HexabitzPlatform/H05R0x/README.md

# H05R0x-Hardware
Hexabitz 1S Lipo Charger w/ USB-C Module Hardware Design
