HexabitzPlatform/H05R0x/Rleased/BOM/H05R0.xlsx

 |  | www.hexabitz.com info@hexabitz.com |  | Bill Of Materials
Customer | Hexabitz | Revision | 1
Project | Hexabitz Modules | Date | 2024-10-07
Board | 1s Lipo charger w/ USB-C (H05R0) | Notes
Designator | Description | Manufacturer Part Number | Manufacturer | Octopart Url | Quantity
R | Headers & Wire Housings Unshrouded 1 POS T/H | 5-146280-1 | TE Connectivity | https://octopart.com/5-146280-1-te+connectivity+%2F+amp-40259676?r=sp | 1
EXT_TH_J, PIO_J | 2 Position Total Single Row 2.54 mm Pitch Straight Male Thru-Hole Header | M20-9990245 | HARWIN INC | https://octopart.com/m20-9990245-harwin-7492269?r=sp | 2
SWD | Conn Unshrouded Header HDR 3 POS 2.54mm Solder ST Top Entry Thru-Hole Carton | 5-146281-3 | TE Connectivity | https://octopart.com/5-146281-3-te+connectivity+%2F+amp-39745942?r=sp | 1
BAT_J | Wire-To-Board Connector, Top Entry, 2 mm, 2 Contacts, Header, PH Series, Through Hole, 1 Rows | b2b-ph-k-s(lf)(sn) | JST | https://octopart.com/b2b-ph-k-s%28lf%29%28sn%29-jst-248868?r=sp | 1
BAT_J2 | VH Series 2 Position 3.96 mm Pitch Disconnectable Crimp Style Shrouded Header | B2P-VH-FB-B(LF)(SN) | JST | https://octopart.com/b2p-vh-fb-b%28lf%29%28sn%29-jst-3990178?r=sp | 1
USB_C | CONN RCP USB3.1 TYPEC 24P SMD RA | 12401610E4#2A | Amphenol ICC | https://octopart.com/12401610e4%232a-amphenol+communications+solutions-126516878?r=sp | 1
VBUS_OUT_J | 2pin Terminal Block; Printed Circuit; 10 A; 160 V; 3.5 mm; 2; 3.5 mm; 1.2 mm; M2; PA | 1984617 | Phoenix Contact | https://octopart.com/1984617-phoenix+contact-58834?r=sp&s=Ef_UaV1JSFmY0wggQyN1Mw | 1
R5 | RES 0.003 OHM 1.0 W 1% 1206 SMD | WFC12063L000FE66 | Vishay | https://octopart.com/wfc12063l000fe66-vishay+dale-125245933?r=sp | 1
R1 | Current Sense Resistors - SMD 1/2W 10m ohm 1% | KRL1220E-M-R010-F-T5 | Susumu | https://octopart.com/krl1220e-m-r010-f-t5-susumu-24927387?r=sp | 1
R12 | RES 10 OHM 1% 1/10W 0603 | CRCW060310R0FKEB | Vishay | https://octopart.com/crcw060310r0fkeb-vishay-42507905?r=sp | 1
R9, R15, R16, R17, R29 | RES 100 OHM 1% 1/10W 0603 | AC0603FR-13100RL | Yageo | https://octopart.com/ac0603fr-13100rl-yageo-74169481?r=sp | 5
R2,R24 | Thick Film Resistors - SMD 0603 270 Ohm 5% Tol | ERJ-3GEYJ271V | Panasonic | https://octopart.com/erj-3geyj271v-panasonic-55560546?r=sp | 2
R4, R6, R7, R10, R18 | RES 1K OHM 1% 1/10W 0603 | AC0603FR-131KL | Yageo | https://octopart.com/ac0603fr-131kl-yageo-73876229?r=sp | 5
R33 | RES THICK FILM 2K OHM 1/10W 1% 0603 SMD | RC0603FR-072KL | YAGEO | https://octopart.com/rc0603fr-072kl-yageo-39838380?r=sp | 1
R3, R11, R21, R37, R39 | RES 10K Ohm 1% 0603 | RC0603FR-0710KL | Yageo | https://octopart.com/rc0603fr-0710kl-yageo-40025538?r=sp | 5
R13, R14 | NTC Thermistors 10K OHM 1% | NCP18XH103F03RB | Murata Electronics | https://octopart.com/ncp18xh103f03rb-murata-746135?r=sp | 2
R27, R31 | RES THICK FILM 20.0K OHM 1/10W 1% 0603 SMD | RC0603FR-0720KL | Yageo | https://octopart.com/rc0603fr-0720kl-yageo-1197359?r=sp | 2
R35, R36 | 0603 22K Ohm 1% 0.1W | RMCF0603FG22K0 | Stackpole Electronics | https://octopart.com/rmcf0603fg22k0-stackpole+electronics-19773159?r=sp | 2
R32 | RES SMD 27K OHM 1% 1/10W 0603 | AC0603FR-0727KL | Yageo | https://octopart.com/ac0603fr-0727kl-yageo-28165829?r=sp | 1
R26 | RES 47K OHM 1% 1/10W 0603 | RC0603FR-0747KL | Yageo | https://octopart.com/rc0603fr-0747kl-yageo-1369017?r=sp | 1
R8, R20 | RES 49.9K OHM 1% 1/10W 0603 | RC0603FR-0749K9L | Yageo | https://octopart.com/rc0603fr-0749k9l-yageo-1186134?r=sp | 2
R22, R34 | RES 100K OHM 1% 1/10W 0603 | RC0603FR-07100KL | Yageo | https://octopart.com/rc0603fr-07100kl-yageo-40946036?r=sp | 2
R25, R28 | RES SMD 220K OHM 5% 1/10W 0603 | 0603WAJ0224T5E | ROYAL OHM | https://octopart.com/0603waj0224t5e-royal+ohm-127836159?r=sp | 2
R38 | RES 1M OHM 1% 1/10W 0603 | RC0603FR-071ML | Yageo | https://octopart.com/rc0603fr-071ml-yageo-1168402?r=sp | 1
R19 | RES 2M OHM 1% 1/10W 0603 | RC0603FR-102ML | Yageo | https://octopart.com/rc0603fr-102ml-yageo-16255871?r=sp | 1
C9, C14 | CAP CER 1000PF 50V C0G/NPO 0603 | CC0603KRNPO9BN102 | YAGEO | https://octopart.com/cc0603krnpo9bn102-yageo-65850404?r=sp | 2
C18 | CAP CER 0.022UF 50V X7R 0603 | C1608X7R1H223K080AA | TDK CORPORAT ION [VA] | https://octopart.com/c1608x7r1h223k080aa-tdk-25947667?r=sp | 1
C10, C16 | Cap Ceramic 0.033uF 16V X7R 10% SMD 1.6 x 0.8 mm 125 C Paper T/R | C0603C333K4RACTU | KEMET [VA] | https://octopart.com/c0603c333k4ractu-kemet-9143755?r=sp | 2
C1, C2, C4, C12, C13, C21, C22, C23, C24, C25, C26, C27, C31 | CAP CER 0.1 UF 25V 10% X7R 0603 | CL10B104KA8NNNC | Samsung Electro-Mechanics | https://octopart.com/cl10b104ka8nnnc-samsung-19831573?r=sp | 13
C17 | 0603 0.47 uF 10 V ±10% Tolerance X7R Surface Mount Multilayer Ceramic Capacitor | GRM188R71A474KA61D | Murata | https://octopart.com/grm188r71a474ka61d-murata-11812018?r=sp | 1
C5, C6, C20, C28, C29, C30 | CAP CER 1 UF 16V X7R 0805 | CC0805KKX7R7BB105 | YAGEO [VA] | https://octopart.com/cc0805kkx7r7bb105-yageo-8376555?r=sp | 6
C3 , C7 | CAP CER 4.7UF 16V X7R 0805 | C0805C475K4RACTU | KEMET [VA] | https://octopart.com/c0805c475k4ractu-kemet-22859922?r=sp | 2
C19, C11, C15 | Cap Ceramic 10uF 25V X5R 10% Pad SMD 0805 | 08053D106KAT2A | AVX | https://octopart.com/08053d106kat2a-avx-71037153?r=sp | 3
C8, C32 | Cap Ceramic 22uF 35V JB 20% Pad SMD 0805 85C T/R | C2012JB1V226M125AC | TDK | https://octopart.com/c2012jb1v226m125ac-tdk-28168958?r=sp | 2
FB1 | Ind chip Bead Multi-Layer 30 ohms 25% 100MHZ Ferrite 1,5A 0603Punched paper T/R | MMZ1608Y300BTA00 | TDK | https://octopart.com/mmz1608y300bta00-tdk-7906990?r=sp | 1
D1 | Red 0603 130° Clear 54 mcd 2 V Surface Mount ChipLED | VLMS1300-GS08 | Vishay | https://octopart.com/vlms1300-gs08-vishay-21709201?r=sp | 1
D2 | V-Ref Adjustable 2.5V to 24V 100mA 3-Pin SOT-23 T/R / IC VREF SHUNT ADJ SOT23-3 | TS2431BILT | STMicroelectronics | https://octopart.com/ts2431bilt-stmicroelectronics-527041?r=sp | 1
D3 | LED Uni-Color True Green 530nm 2-Pin Chip 0603(1608Metric) T/R | VLMTG1300-GS08 | Vishay | https://octopart.com/vlmtg1300-gs08-vishay-21709202?r=sp | 1
D4 | TVS DIODE 3,3V 10,9V SOD323 | CDSOD323-T03SC | BOURNS INC | https://octopart.com/cdsod323-t03sc-bourns-10487153?r=sp | 1
D5, D6, D7 | Schottky Diode, 30V, 1A, Sod-323 | CUS10S30,H3F(T | Toshiba | https://octopart.com/cus10s30%2Ch3f%28t-toshiba-98975237?r=sp | 3
Q1 | Transistor MOSFET Array Dual N-CH 30V 28A 8-Pin PowerPAK 1212 | SISF06DN-T1-GE3 | Vishay | https://octopart.com/sisf06dn-t1-ge3-vishay-108916351?r=sp | 1
U1 | MCU 32-bit ARM Cortex M0+ RISC 512KB Flash 1.8V/2.5V/3.3V 48-Pin UFQFPN EP Tray | STM32G0B1CEU6 | STMicroelectronics | https://octopart.com/stm32g0b1ceu6-stmicroelectronics-116363364?r=sp | 1
U2 | Battery Management 1 Cell Fuel Gauge with ModelGauge m5 EZ, Charger, Protector and SHA-256 Authentication | MAX17330X22+T | Analog Devices / Maxim Integrated | https://octopart.com/max17330x22%2Bt-analog+devices-119633547?r=sp | 1
U3 | Op Amp Dual High Bandwidth Amplifier R-R I/O 5.5V 8-Pin DFN EP T/R | TSV772IQ2T | STMicroelectronics | https://octopart.com/tsv772iq2t-stmicroelectronics-123138659?r=sp | 1
U4 | LDO Voltage Regulators 2 A high PSRR ultra low drop linear regulator reverse current protection | LD39200PU33R | STMicroelectronics | https://octopart.com/ld39200pu33r-stmicroelectronics-49646134?r=sp | 1
U5 | 0.5V~13.5V 12.8mΩ 10.5A DFN-8(2x2) Power Distribution Switches ROHS | NCP45521IMNTWG-L | onsemi | https://octopart.com/ncp45521imntwg-l-onsemi-24638146?r=sp | 1
U6 | 300 mA 3.3 V Fixed Low Noise LDO Voltage Regulator - SOT-323-5 | LDK130C33R | STMicroelectronics | https://octopart.com/ldk130c33r-stmicroelectronics-29288945?r=sp | 1
X1 | 8,0000MHZ 33pF SMD MURATA Resonators | CSTNE8M00G550000R0 | Murata | https://octopart.com/cstne8m00g550000r0-murata-91406934?r=sp | 1
