HexabitzPlatform/H05R0x/Documentation/H05R0 Schematics.pdf

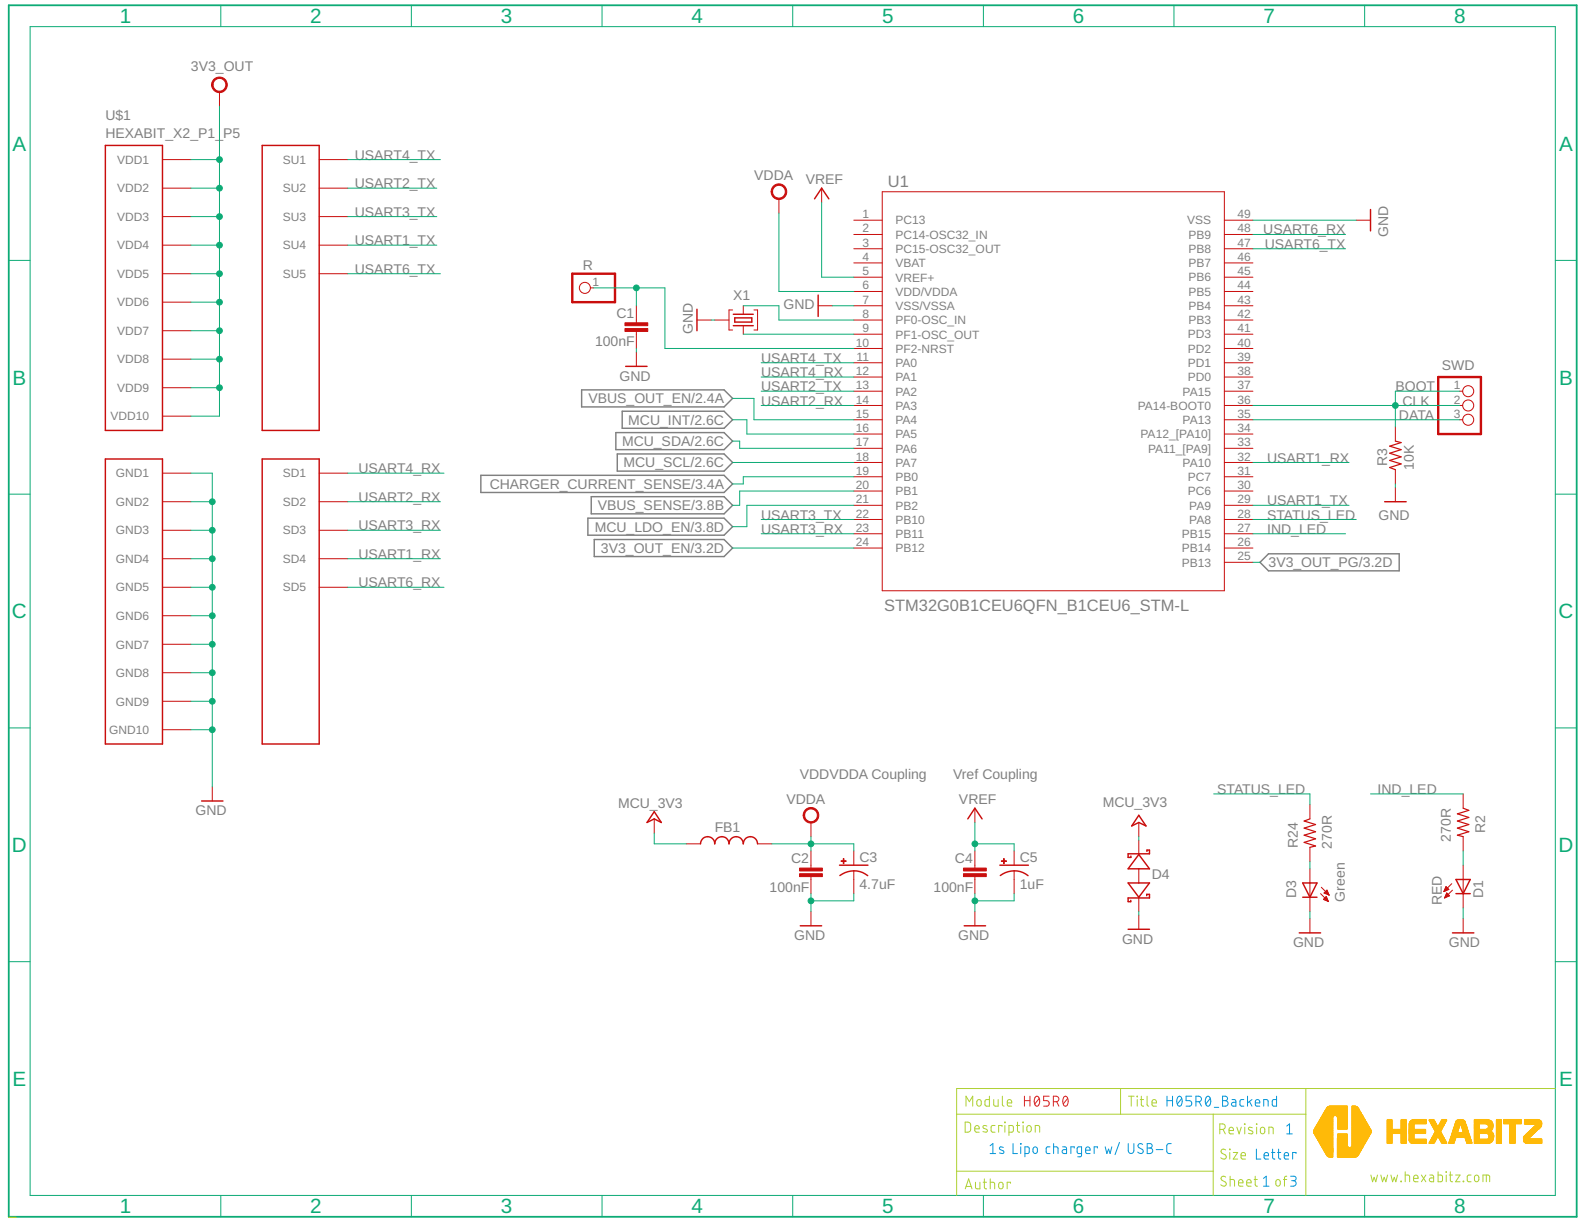
[picture p1: page 1]

35 PA14-BOOT0 | DATA
32 PA11_[PA9] 33 PA12_[PA10] 34 PA13 USART1_RX STATUS_LED GND IND_LED

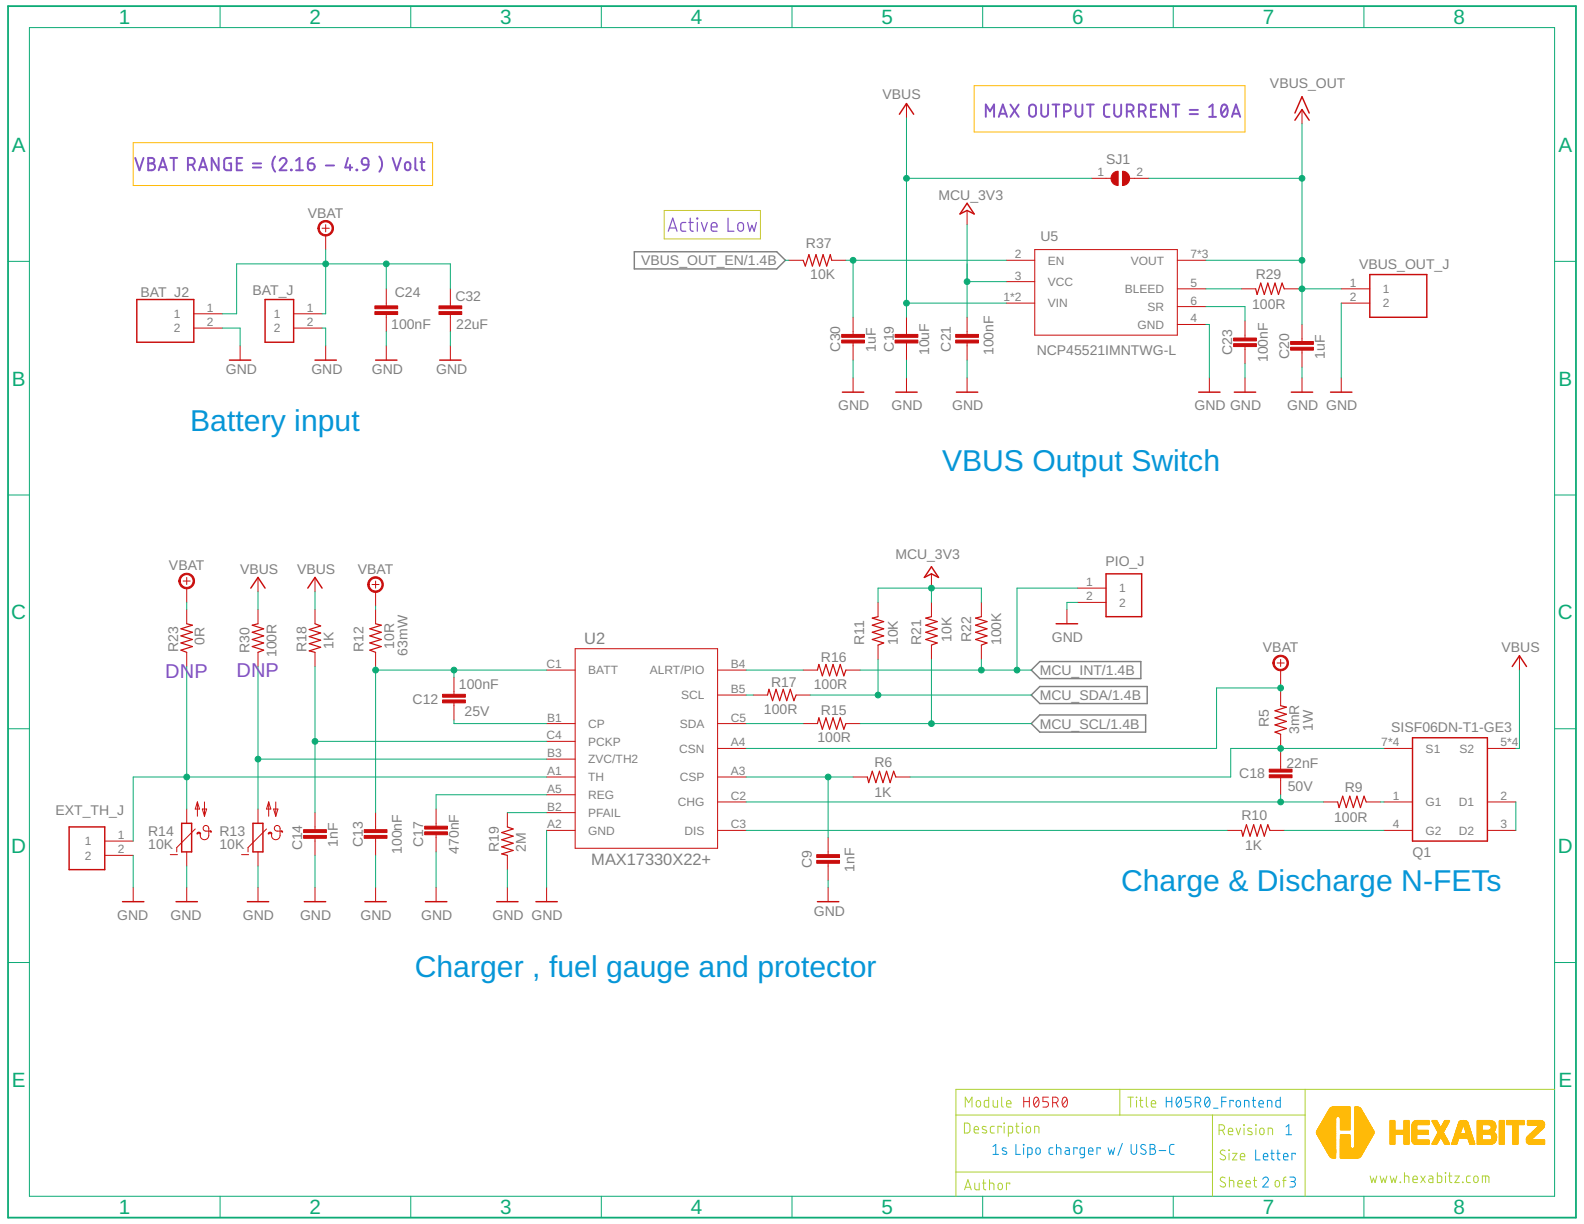
[picture p2: page 2]

Charger , fuel gauge and protector

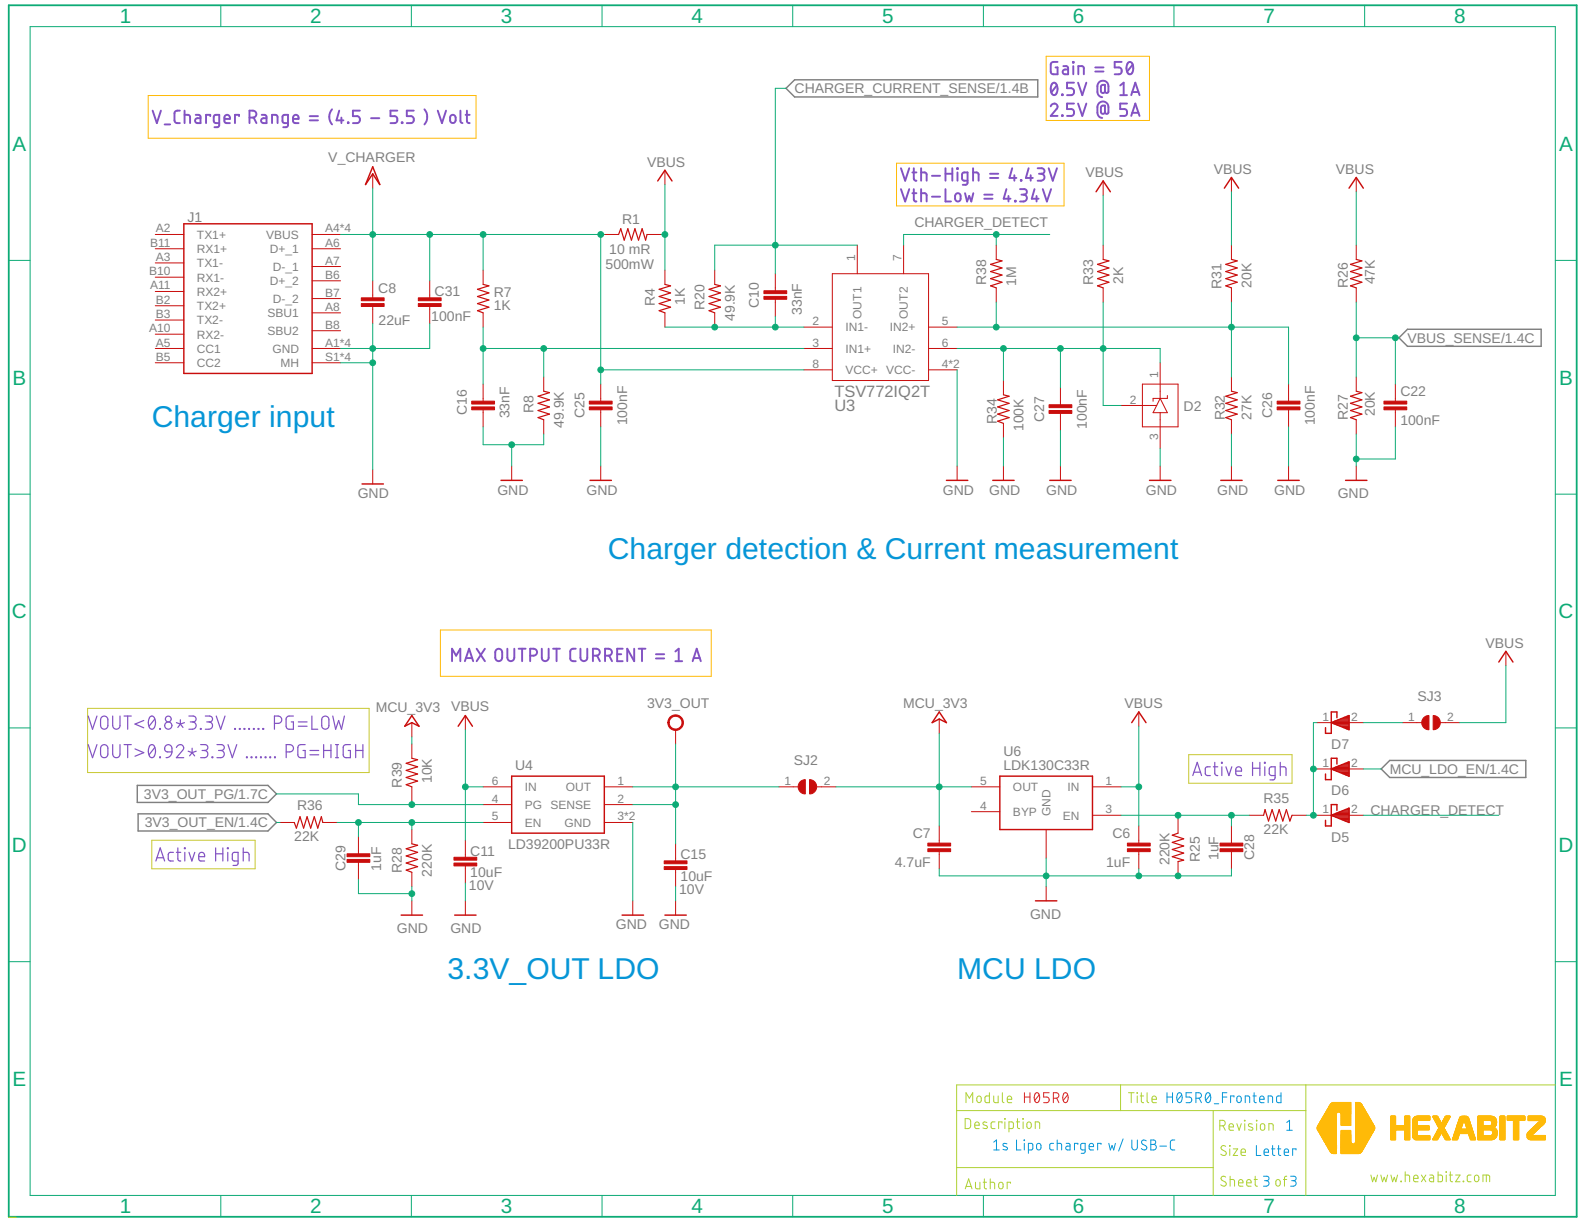
[picture p3: page 3]

Charger detection & Current measurement
