HexabitzPlatform/H05R0x/Design/H05R0.brd

## EAGLE design Design/H05R0.brd (2024-10-08)

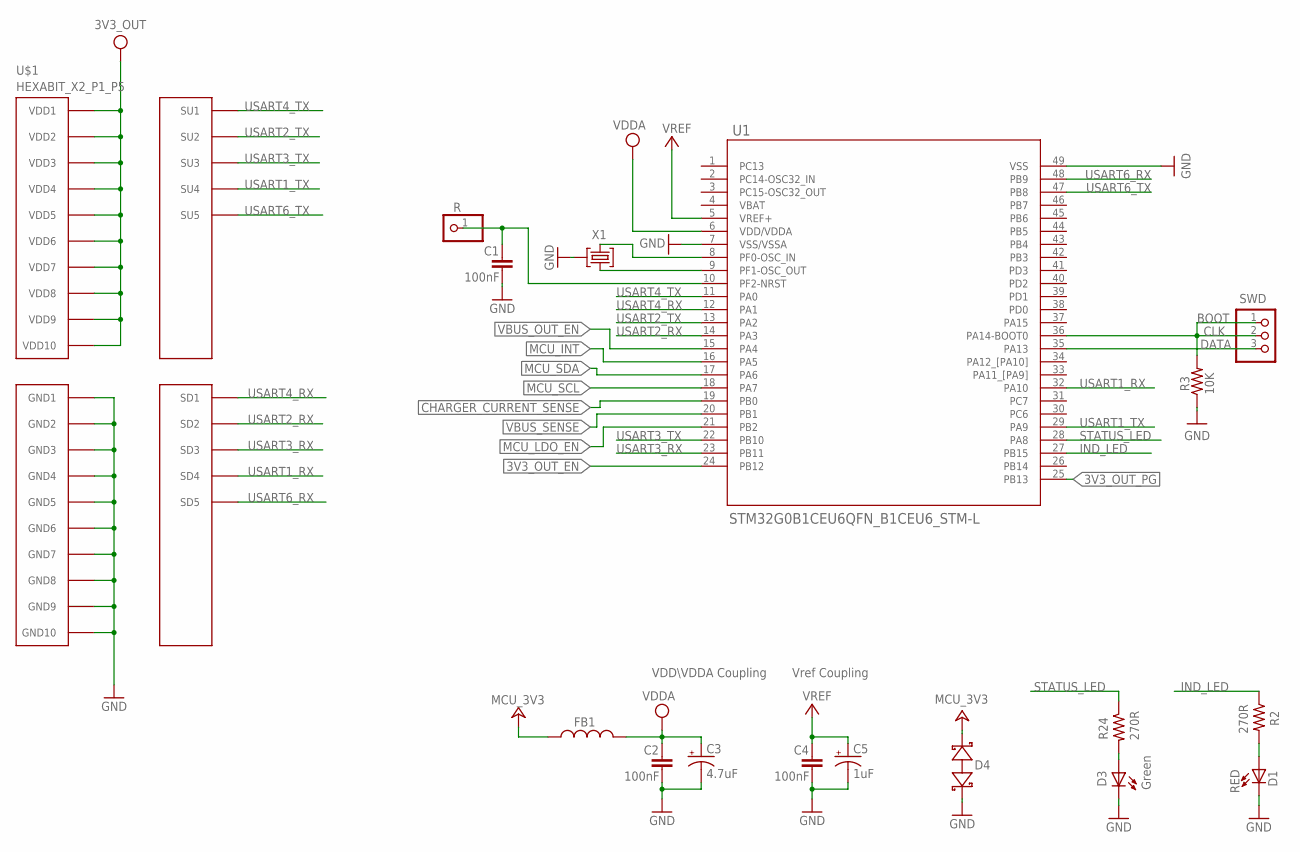
[picture p4: schematic H05R0.sch, sheet 1]

Parts:
C1, C2, C4: 100nF; C-0603
C3: 4.7uF; C-0805-POL
C5: 1uF; C-0805-POL
D1: RED; VLMS1300-GS08; MPN VLMS1300-GS08
D3: Green; VLMTG1300-GS08; MPN VLMS1300-GS08
D4: BOURNS_CDSOD323-T03SCBOURNS_CDSOD323-T03SC_0_0; BOURNS_CDSOD323-T03SC_0
FB1: FB-0603
R: R; 1X01
R2, R24: 270R; R-0603
R3: 10K; R-0603
SWD: PINHD-1X3; 1X03
TRIMBLE-LOGO1: HEXA-LOGO
U1: STM32G0B1CEU6QFN_B1CEU6_STM-L; QFN_B1CEU6_STM-L
U$1: HEXABIT_X2_P1_P5; HEXABIT_17.32_X2_P1_P5
X1: XTALL_CSTCE8M00G52

Connections:
3V3_OUT: U$1.PAD_PU11 (VDD1), U$1.PAD_PU12 (VDD2), U$1.PAD_PU13 (VDD3), U$1.PAD_PU14 (VDD4), U$1.PAD_PU15 (VDD5), U$1.PAD_PU16 (VDD6), U$1.PAD_PU17 (VDD7), U$1.PAD_PU18 (VDD8), U$1.PAD_PU19 (VDD9), U$1.PAD_PU20 (VDD10); also elsewhere on the board
3V3_OUT_EN: U1.24 (PB12); also elsewhere on the board
3V3_OUT_PG: U1.25 (PB13); also elsewhere on the board
CHARGER_CURRENT_SENSE: U1.19 (PB0); also elsewhere on the board
CLK: R3.2, SWD.1, SWD.2, U1.36 (PA14-BOOT0)
DATA: SWD.3, U1.35 (PA13)
GND: C1.2, C2.2, C3.2 (-), C4.2, C5.2 (-), D1.C, D3.C, D4.1 (A), R3.1, U1.7 (VSS/VSSA), U1.49 (VSS), U$1.PAD_PD11 (GND1), U$1.PAD_PD12 (GND2), U$1.PAD_PD13 (GND3), U$1.PAD_PD14 (GND4), U$1.PAD_PD15 (GND5), U$1.PAD_PD16 (GND6), U$1.PAD_PD17 (GND7), U$1.PAD_PD18 (GND8), U$1.PAD_PD19 (GND9), U$1.PAD_PD20 (GND10), X1.P$2 (2); also elsewhere on the board
IND_LED: R2.1, U1.27 (PB15)
MCU_3V3: D4.2 (C), FB1.2; also elsewhere on the board
MCU_INT: U1.16 (PA5); also elsewhere on the board
MCU_LDO_EN: U1.21 (PB2); also elsewhere on the board
MCU_SCL: U1.18 (PA7); also elsewhere on the board
MCU_SDA: U1.17 (PA6); also elsewhere on the board
unnamed: D1.A, R2.2
unnamed: D3.A, R24.2
unnamed: U1.9 (PF1-OSC_OUT), X1.P$1 (1)
unnamed: U1.8 (PF0-OSC_IN), X1.P$3 (3)
unnamed: C1.1, R.1, U1.10 (PF2-NRST)
STATUS_LED: R24.1, U1.28 (PA8)
USART1_RX: U1.32 (PA10), U$1.PAD_PD4 (SD4)
USART1_TX: U1.29 (PA9), U$1.PAD_PU4 (SU4)
USART2_RX: U1.14 (PA3), U$1.PAD_PD2 (SD2)
USART2_TX: U1.13 (PA2), U$1.PAD_PU2 (SU2)
USART3_RX: U1.23 (PB11), U$1.PAD_PD3 (SD3)
USART3_TX: U1.22 (PB10), U$1.PAD_PU3 (SU3)
USART4_RX: U1.12 (PA1), U$1.PAD_PD1 (SD1)
USART4_TX: U1.11 (PA0), U$1.PAD_PU1 (SU1)
USART6_RX: U1.48 (PB9), U$1.PAD_PD5 (SD5)
USART6_TX: U1.47 (PB8), U$1.PAD_PU5 (SU5)
VBUS_OUT_EN: U1.15 (PA4); also elsewhere on the board
VBUS_SENSE: U1.20 (PB1); also elsewhere on the board
VDDA: C2.1, C3.1 (+), FB1.1, U1.6 (VDD/VDDA)
VREF: C4.1, C5.1 (+), U1.5 (VREF+)

Notes on the sheet:
Vref Coupling
VDD\VDDA Coupling
BOOT

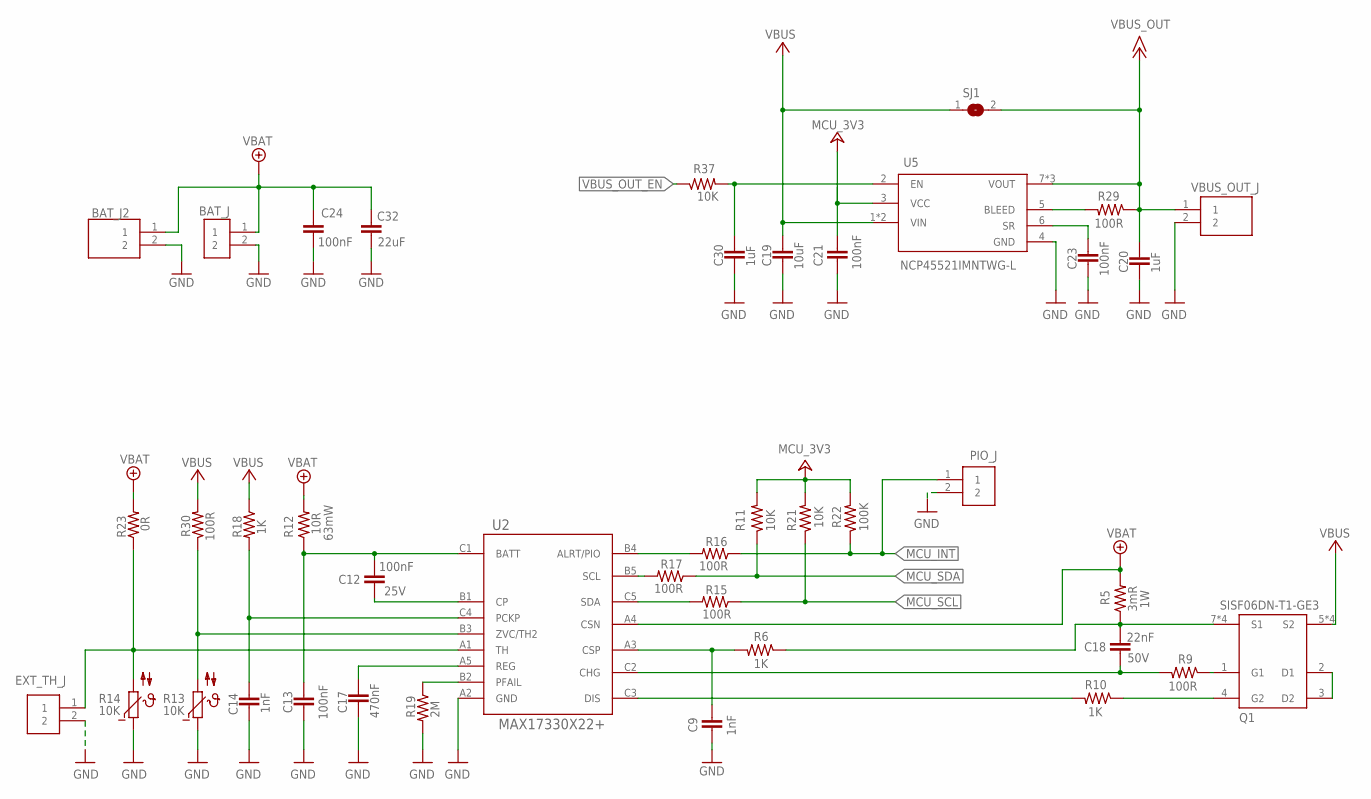
[picture p5: schematic H05R0.sch, sheet 2]

Parts:
BAT_J: B2B-PH-K-S(LF)(SN); JST_B2B-PH-K-S(LF)(SN)
BAT_J2: B2P-VH-FB-B_LF__SN_; B2PVHFBBLFSN
C9, C14: 1nF; C-0603; VOLTAGE_RATING 50V
C12: 100nF; C-0603; VOLTAGE_RATING 25V
C13: 100nF; C-0603; VOLTAGE_RATING 10V
C17: 470nF; C-0603; VOLTAGE_RATING 10V
C18: 22nF; C-0603; VOLTAGE_RATING 50V
C19: 10uF; C-0805
C20: 1uF; C-0805
C21, C23: 100nF; C-0603; VOLTAGE_RATING 10V; MPN GRM187R61A226ME15
C24: 100nF; C-0603; VOLTAGE_RATING 50V
C30: 1uF; C-0805; VOLTAGE_RATING 10V; MPN GRM187R61A226ME15
C32: 22uF; C-0805
EXT_TH_J: 3-644456-2; TE_3-644456-2
PIO_J: 3-644456-2; TE_3-644456-2
Q1: SISF06DN-T1-GE3; SISF06DNT1GE3
R5: 3mR; R1206; MPN WFC12063L000FE66
R6, R10, R18: 1K; R-0603
R9, R15, R16, R17, R29, R30: 100R; R-0603
R11, R21, R37: 10K; R-0603
R12: 10R; R-0603
R13, R14: 10K; R-0603; MPN NCP18XH103F03RB
R19: 2M; R-0603
R22: 100K; R-0603
R23: DNP; R-0603
SJ1: SJ
U2: MAX17330X22+; 21-100433_W151J2+1_MXM
U5: NCP45521IMNTWG-L; DFN8_2X2_ONS
VBUS_OUT_J: 1984617

Connections:
GND: BAT_J.2, BAT_J2.2, C9.1, C13.2, C14.2, C17.1, C19.2, C20.2, C21.1, C23.1, C24.1, C30.1, C32.2, EXT_TH_J.2, PIO_J.2, R13.1, R14.1, R19.2, U2.A2 (GND), U5.4 (GND), VBUS_OUT_J.2; also elsewhere on the board
MCU_3V3: C21.2, R11.2, R21.2, R22.2, U5.3 (VCC); also elsewhere on the board
MCU_INT: PIO_J.1, R16.1, R22.1; also elsewhere on the board
MCU_SCL: R15.1, R21.1; also elsewhere on the board
MCU_SDA: R11.1, R17.1; also elsewhere on the board
unnamed: C30.2, R37.2, U5.2 (EN)
unnamed: R19.1, U2.B2 (PFAIL)
unnamed: C18.2, R9.2, U2.C2 (CHG)
unnamed: Q1.4 (G2), R10.1
unnamed: C9.2, R6.2, U2.A3 (CSP)
unnamed: C18.1, Q1.7 (S1), Q1.8 (S1), Q1.9 (S1), Q1.11 (S1), R5.1, R6.1
unnamed: Q1.2 (D1), Q1.3 (D2)
unnamed: R16.2, U2.B4 (ALRT/PIO)
unnamed: R17.2, U2.B5 (SCL)
unnamed: R13.2, R30.1, U2.B3 (ZVC/TH2)
unnamed: R10.2, U2.C3 (DIS)
unnamed: C17.2, U2.A5 (REG)
unnamed: C12.1, U2.B1 (CP)
unnamed: C12.2, C13.1, R12.1, U2.C1 (BATT)
unnamed: R29.2, U5.5 (BLEED)
unnamed: R15.2, U2.C5 (SDA)
unnamed: Q1.1 (G1), R9.1
unnamed: C14.1, R18.2, U2.C4 (PCKP)
unnamed: EXT_TH_J.1, R14.2, R23.1, U2.A1 (TH)
unnamed: C23.2, U5.6 (SR)
VBAT: BAT_J.1, BAT_J2.1, C24.2, C32.1, R5.2, R12.2, R23.2, U2.A4 (CSN)
VBUS: C19.1, Q1.5 (S2), Q1.6 (S2), Q1.10 (S2), Q1.12 (S2), R18.1, R30.2, SJ1.1, U5.1 (VIN), U5.9 (VIN); also elsewhere on the board
VBUS_OUT: C20.1, R29.1, SJ1.2, U5.7 (VOUT), U5.8 (VOUT), U5.10 (VOUT), VBUS_OUT_J.1
VBUS_OUT_EN: R37.1; also elsewhere on the board

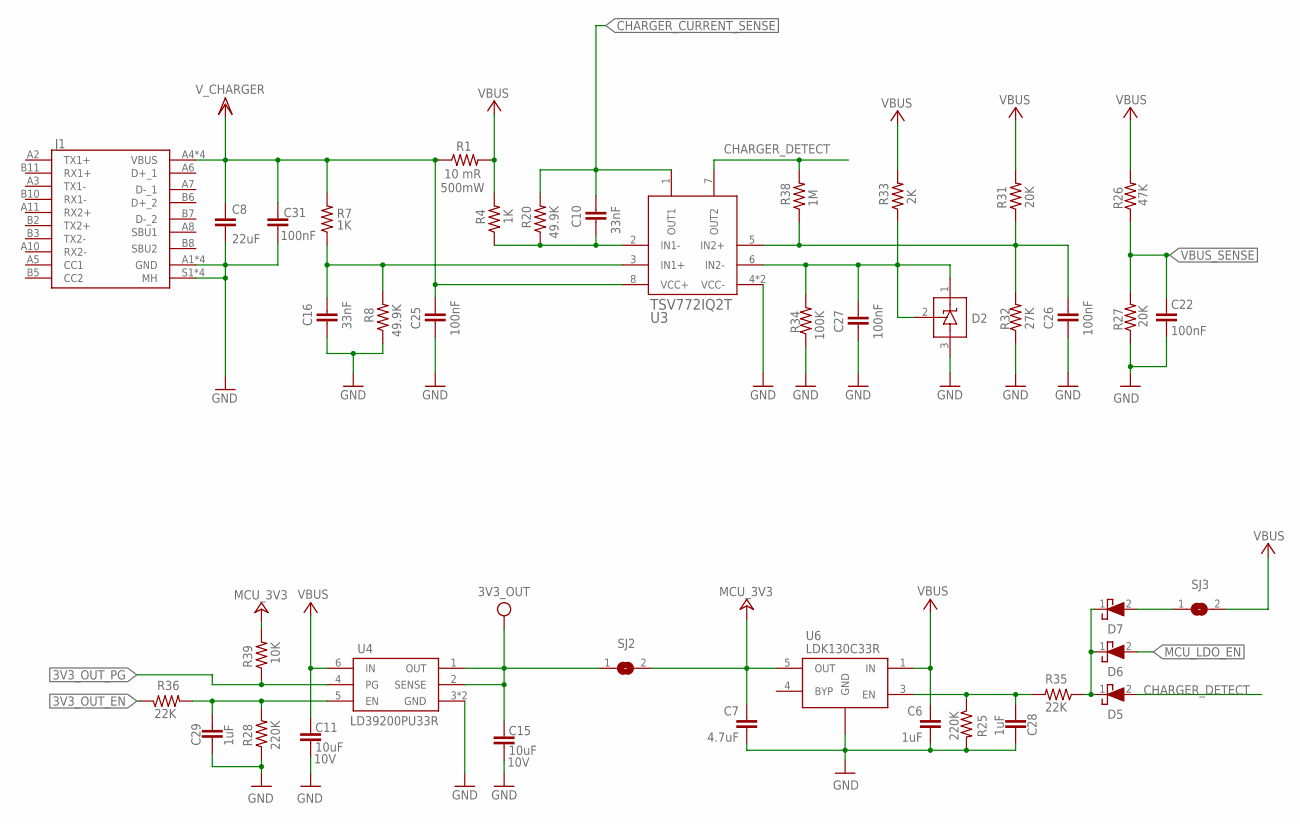
[picture p6: schematic H05R0.sch, sheet 3]

Parts:
C6: 1uF; C-0805
C7: 4.7uF; C-0805
C8: 22uF; C-0805
C10, C16: 33nF; C-0603; VOLTAGE_RATING 50V
C11, C15: 10uF; C-0805; VOLTAGE_RATING 10V; MPN GRM187R61A226ME15
C22, C25, C26, C27, C31: 100nF; C-0603; VOLTAGE_RATING 50V
C28, C29: 1uF; C-0805; VOLTAGE_RATING 10V; MPN GRM187R61A226ME15
D2: TL431QDBZR,215; SOT23_TO-236AB_NEX; MANUFACTURER_PART_NUMBER TS2431BILT
D5, D6, D7: CUS10S30,H3F; 1SS357TPH3F
J1: 12401610E4#2A12401610E42A; AMPHENOL_12401610E4_2A
R1: 10 mR; R-0805
R4, R7: 1K; R-0603
R8, R20: 49.9K; R-0603
R25: 220K; R-0603
R26: 47K; R-0603
R27, R31: 20K; R-0603
R28: 220K; R-0603; TOLERANCE 1%
R32: 27K; R-0603
R33: 2K; R-0603
R34: 100K; R-0603
R35, R36: 22K; R-0603
R38: 1M; R-0603
R39: 10K; R-0603; TOLERANCE 1%
SJ2, SJ3: SJ
U3: TSV772IQ2T; SON50P200X200X60-9N
U4: LD39200PU33R; SON95P300X300X100-7N
U6: LDK130C33R; SOT65P210X110-5N

Connections:
3V3_OUT: C15.2, SJ2.1, U4.1 (OUT), U4.2 (SENSE); also elsewhere on the board
3V3_OUT_EN: R36.1; also elsewhere on the board
3V3_OUT_PG: R39.1, U4.4 (PG); also elsewhere on the board
CHARGER_CURRENT_SENSE: C10.2, R20.2, U3.1 (OUT1); also elsewhere on the board
CHARGER_DETECT: D5.2 (A), R38.2, U3.7 (OUT2)
GND: C6.2, C7.2, C8.2, C11.1, C15.1, C16.1, C22.2, C25.1, C26.1, C27.1, C28.1, C29.1, C31.1, D2.3, J1.A1 (GND), J1.A12 (GND), J1.B1 (GND), J1.B12 (GND), J1.S1 (MH), J1.S2 (MH), J1.S3 (MH), J1.S4 (MH), R8.1, R25.2, R27.1, R28.1, R32.1, R34.1, U3.4 (VCC-), U3.9 (VCC-), U4.3 (GND), U4.7 (GND), U6.2 (GND); also elsewhere on the board
MCU_3V3: C7.1, R39.2, SJ2.2, U6.5 (OUT); also elsewhere on the board
MCU_LDO_EN: D6.2 (A); also elsewhere on the board
unnamed: C10.1, R4.1, R20.1, U3.2 (IN1-)
unnamed: C28.2, R25.1, R35.2, U6.3 (EN)
unnamed: C16.2, R7.1, R8.2, U3.3 (IN1+)
unnamed: C29.2, R28.2, R36.2, U4.5 (EN)
unnamed: D5.1 (K), D6.1 (K), D7.1 (K), R35.1
unnamed: D7.2 (A), SJ3.1
VBUS: C6.1, C11.2, R1.2, R4.2, R26.2, R31.2, R33.2, SJ3.2, U4.6 (IN), U6.1 (IN); also elsewhere on the board
VBUS1: C26.2, R31.1, R32.2, R38.1, U3.5 (IN2+)
VBUS2: C27.2, D2.1, D2.2, R33.1, R34.2, U3.6 (IN2-)
VBUS_SENSE: C22.1, R26.1, R27.2; also elsewhere on the board
VCHARGER: C8.1, C25.2, C31.2, J1.A4 (VBUS), J1.A9 (VBUS), J1.B4 (VBUS), J1.B9 (VBUS), R1.1, R7.2, U3.8 (VCC+)

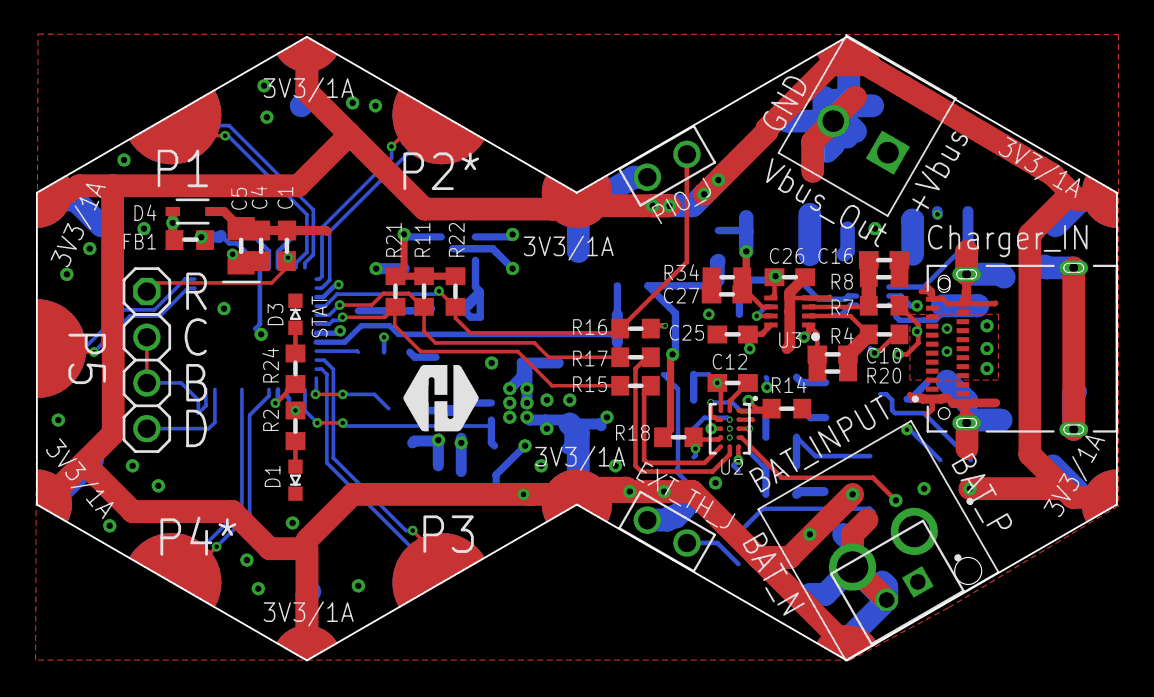
[picture p7: board H05R0.brd from above]

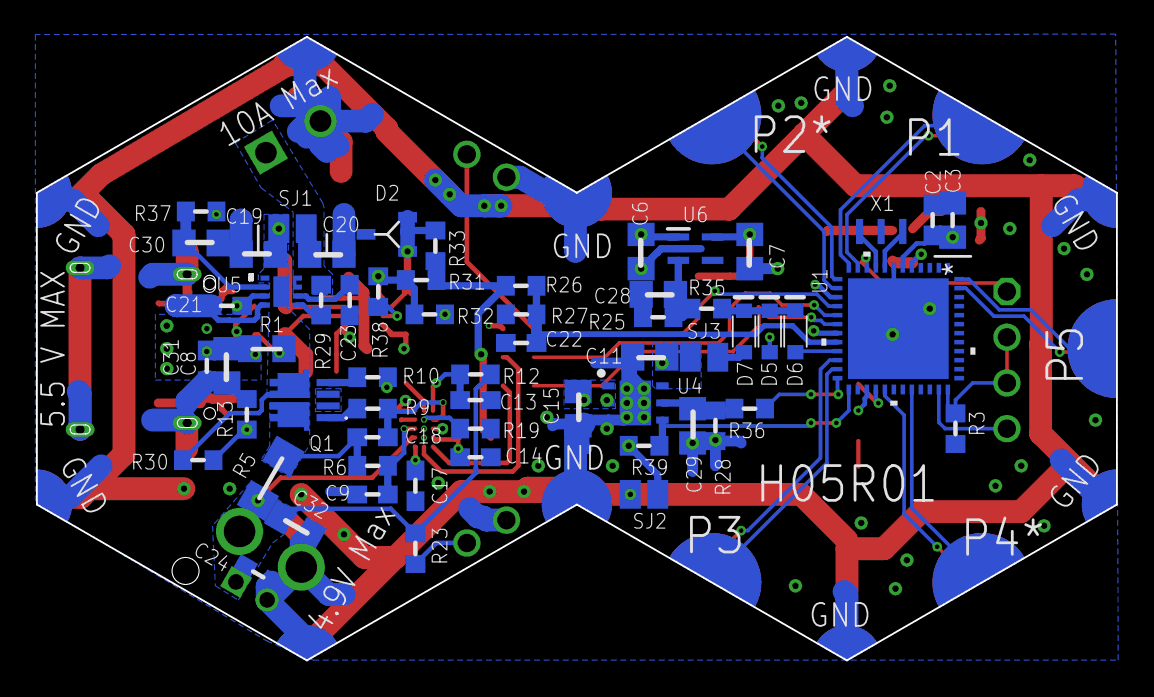
[picture p8: board H05R0.brd from below]

Board: 4 copper layers, 60.0 x 34.6 mm, 100 parts (60 on the bottom side), 66 nets.
