HexabitzPlatform/H05R0x/H05R00/Design/H05R00.brd

## EAGLE design H05R00/Design/H05R00.brd (2023-11-05)

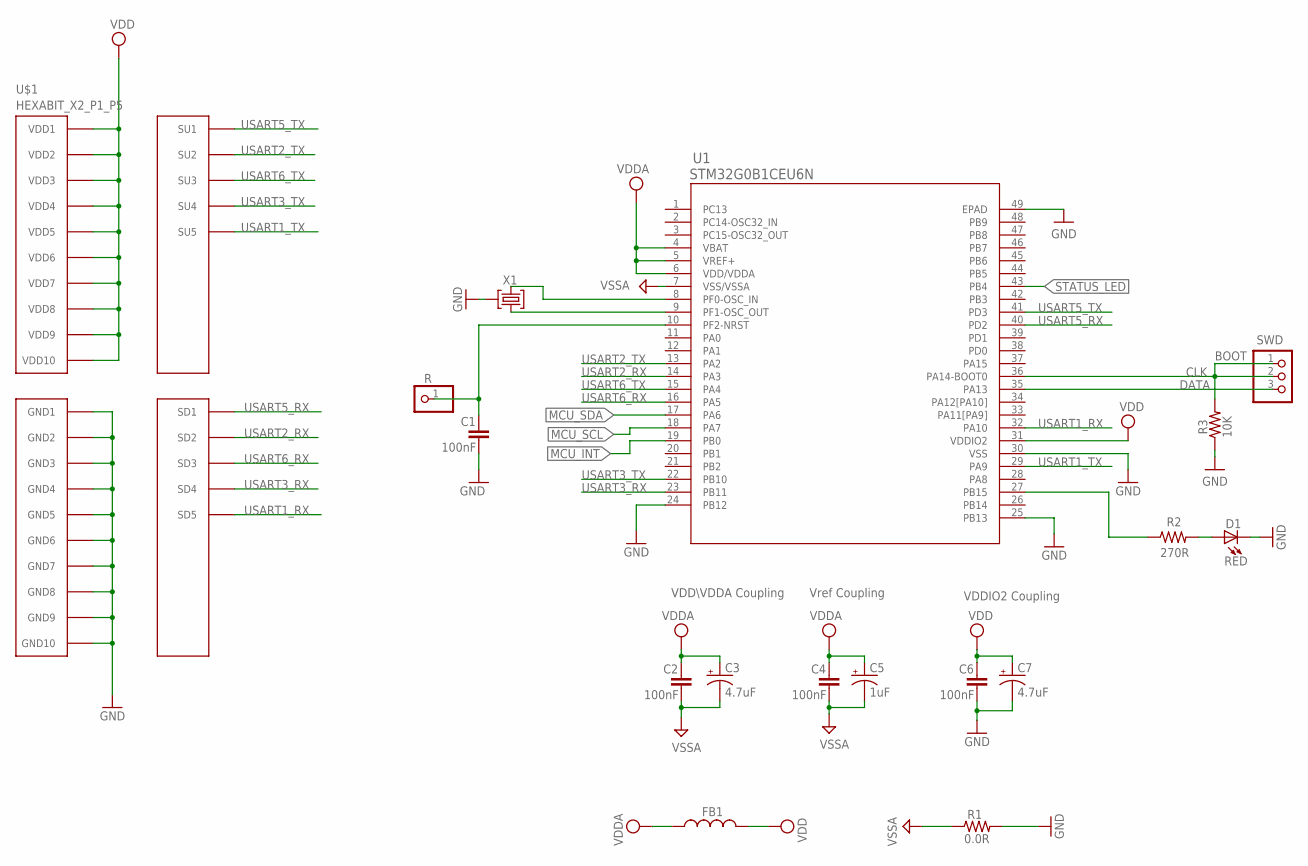
[picture p9: schematic H05R00.sch, sheet 1]

Parts:
C1, C2, C4, C6: 100nF; C-0603
C3, C7: 4.7uF; C-0805-POL
C5: 1uF; C-0805-POL
D1: RED; VLMS1300-GS08; MPN VLMS1300-GS08
FB1: FB-0603
R: R; 1X01
R1: 0.0R; R-0603
R2: 270R; R-0603
R3: 10K; R-0603
SWD: PINHD-1X3; 1X03
U1: STM32G0B1CEU6N; HEXABITZ_ICS_QFN_B1CEU6_STM-L
U$1: HEXABIT_X2_P1_P5; HEXABIT_17.32_X2_P1_P5
X1: XTALL_CSTCE8M00G52

Connections:
CLK: R3.2, SWD.1, SWD.2, U1.36 (PA14-BOOT0)
DATA: SWD.3, U1.35 (PA13)
GND: C1.2, C6.2, C7.2 (-), D1.C, R1.2, R3.1, U1.24 (PB12), U1.25 (PB13), U1.30 (VSS), U1.49 (EPAD), U$1.PAD_PD11 (GND1), U$1.PAD_PD12 (GND2), U$1.PAD_PD13 (GND3), U$1.PAD_PD14 (GND4), U$1.PAD_PD15 (GND5), U$1.PAD_PD16 (GND6), U$1.PAD_PD17 (GND7), U$1.PAD_PD18 (GND8), U$1.PAD_PD19 (GND9), U$1.PAD_PD20 (GND10), X1.P$2 (2); also elsewhere on the board
MCU_INT: U1.19 (PB0); also elsewhere on the board
MCU_SCL: U1.18 (PA7); also elsewhere on the board
MCU_SDA: U1.17 (PA6); also elsewhere on the board
unnamed: D1.A, R2.2
unnamed: R2.1, U1.27 (PB15)
unnamed: U1.9 (PF1-OSC_OUT), X1.P$1 (1)
unnamed: U1.8 (PF0-OSC_IN), X1.P$3 (3)
unnamed: C1.1, R.1, U1.10 (PF2-NRST)
STATUS_LED: U1.43 (PB4); also elsewhere on the board
USART1_RX: U1.32 (PA10), U$1.PAD_PD5 (SD5)
USART1_TX: U1.29 (PA9), U$1.PAD_PU5 (SU5)
USART2_RX: U1.14 (PA3), U$1.PAD_PD2 (SD2)
USART2_TX: U1.13 (PA2), U$1.PAD_PU2 (SU2)
USART3_RX: U1.23 (PB11), U$1.PAD_PD4 (SD4)
USART3_TX: U1.22 (PB10), U$1.PAD_PU4 (SU4)
USART5_RX: U1.40 (PD2), U$1.PAD_PD1 (SD1)
USART5_TX: U1.41 (PD3), U$1.PAD_PU1 (SU1)
USART6_RX: U1.16 (PA5), U$1.PAD_PD3 (SD3)
USART6_TX: U1.15 (PA4), U$1.PAD_PU3 (SU3)
VDD: C6.1, C7.1 (+), FB1.2, U1.31 (VDDIO2), U$1.PAD_PU11 (VDD1), U$1.PAD_PU12 (VDD2), U$1.PAD_PU13 (VDD3), U$1.PAD_PU14 (VDD4), U$1.PAD_PU15 (VDD5), U$1.PAD_PU16 (VDD6), U$1.PAD_PU17 (VDD7), U$1.PAD_PU18 (VDD8), U$1.PAD_PU19 (VDD9), U$1.PAD_PU20 (VDD10); also elsewhere on the board
VDDA: C2.1, C3.1 (+), C4.1, C5.1 (+), FB1.1, U1.4 (VBAT), U1.5 (VREF+), U1.6 (VDD/VDDA)
VSSA: C2.2, C3.2 (-), C4.2, C5.2 (-), R1.1, U1.7 (VSS/VSSA); also elsewhere on the board

Notes on the sheet:
Vref Coupling
VDDIO2 Coupling
VDD\VDDA Coupling
BOOT

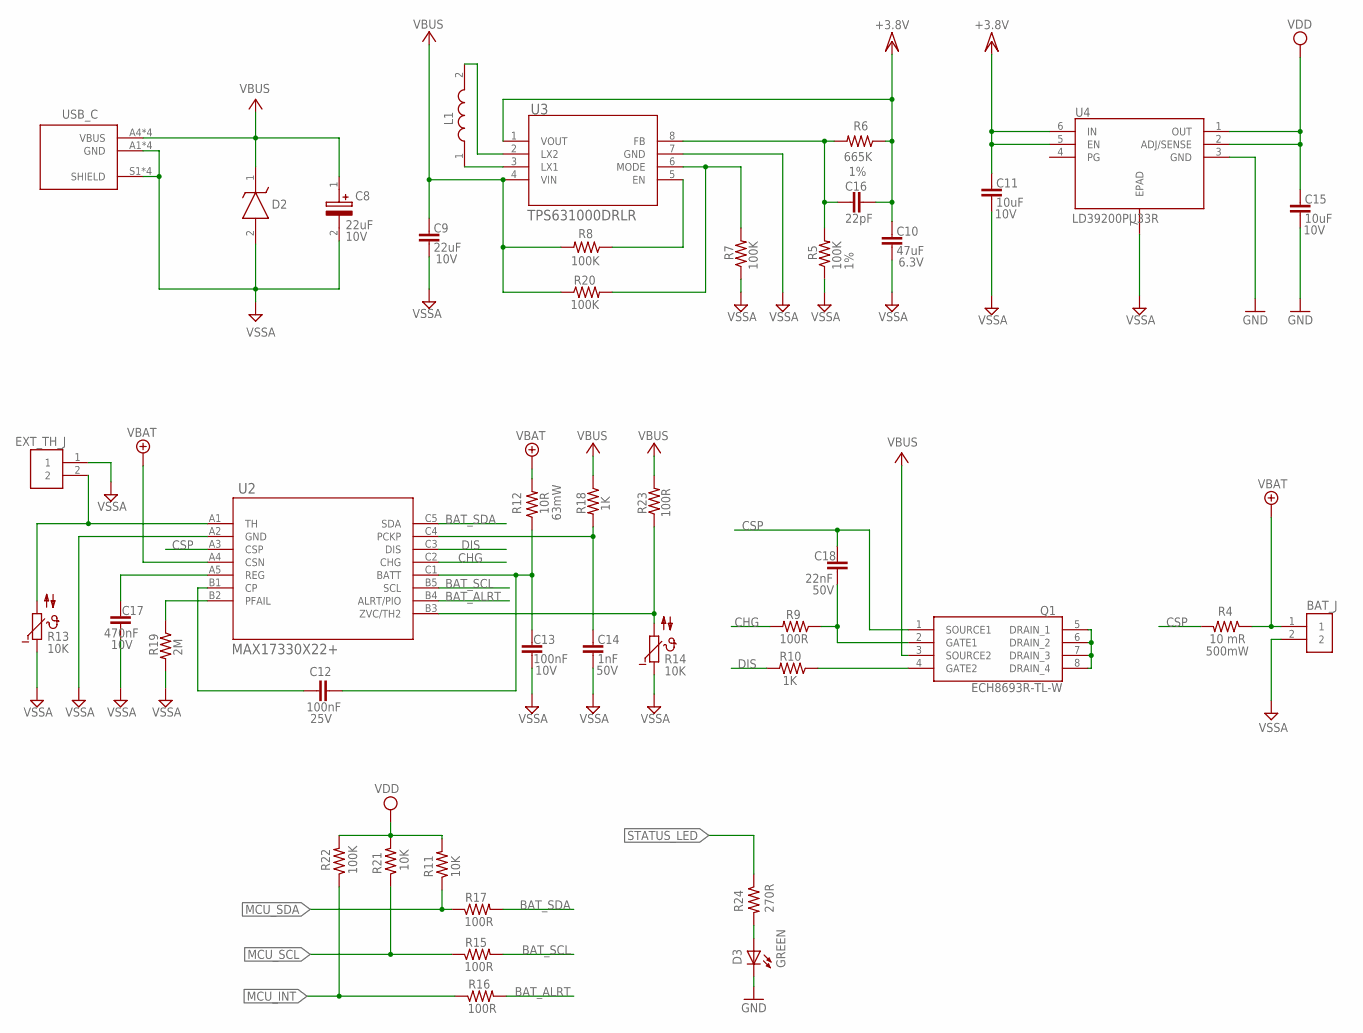
[picture p10: schematic H05R00.sch, sheet 2]

Parts:
BAT_J: B2B-PH-K-S(LF)(SN); JST_B2B-PH-K-S(LF)(SN)
C8: 22uF; T491B; VOLTAGE 10V
C9: 22uF; C-0603; VOLTAGE_RATING 10V; MPN GRM187R61A226ME15
C10: 47uF; C-0603; VOLTAGE_RATING 6.3V; MPN CL10A476MQ8QRN
C11, C15: 10uF; C-0603; VOLTAGE_RATING 10V; MPN GRM187R61A226ME15
C12: 100nF; C-0603; VOLTAGE_RATING 25V
C13: 100nF; C-0603; VOLTAGE_RATING 10V
C14: 1nF; C-0603; VOLTAGE_RATING 50V
C16: 22pF; C-0603
C17: 470nF; C-0603; VOLTAGE_RATING 10V
C18: 22nF; C-0603; VOLTAGE_RATING 50V
D2: UCLAMP0501H.TCT; SODFL1608X70N
D3: GREEN; VLMS1300-GS08; MPN VLMS1300-GS08
EXT_TH_J: 3-644456-2; TE_3-644456-2
L1: DFE252012P-1R0M=P2; DFE2HCAH1R0MJ0L
Q1: ECH8693R-TL-W; SOTFL65P280X95-8N
R4: 10 mR; R-0805
R5: 100K; R-0603; TOLERANCE 1%
R6: 665K; R-0603; TOLERANCE 1%
R7, R8, R20, R22: 100K; R-0603
R9, R15, R16, R17: 100R; R-0603
R10, R18: 1K; R-0603
R11, R21: 10K; R-0603
R12: 10R; R-0603
R13, R14: 10K; R-0603; MPN NCP18XH103F03RB
R19: 2M; R-0603
R23: DNP; R-0603
R24: 270R; R-0603
U2: MAX17330X22+; 21-100433_W151J2+1_MXM
U3: TPS631000DRLR; TPS631000DRLR_TEX
U4: LD39200PU33R; SON95P300X300X100-7N
USB_C: UJC-HP-G-SMT-TR; CUI_UJC-HP-G-SMT-TR

Connections:
+3.8V: C10.2, C11.2, C16.1, R6.1, U3.1 (VOUT), U4.5 (EN), U4.6 (IN)
BAT_ALRT: R16.2, U2.B4 (ALRT/PIO)
BAT_SCL: R15.2, U2.B5 (SCL)
BAT_SDA: R17.2, U2.C5 (SDA)
CHG: R9.2, U2.C2 (CHG)
CSP: C18.1, Q1.1 (SOURCE1), R4.2, U2.A3 (CSP)
DIS: R10.2, U2.C3 (DIS)
GND: C15.1, D3.C, U4.3 (GND); also elsewhere on the board
MCU_INT: R16.1, R22.1; also elsewhere on the board
MCU_SCL: R15.1, R21.1; also elsewhere on the board
MCU_SDA: R11.1, R17.1; also elsewhere on the board
unnamed: D3.A, R24.2
unnamed: R19.1, U2.B2 (PFAIL)
unnamed: Q1.5 (DRAIN_1), Q1.6 (DRAIN_2), Q1.7 (DRAIN_3), Q1.8 (DRAIN_4)
unnamed: C18.2, Q1.2 (GATE1), R9.1
unnamed: L1.2, U3.2 (LX2)
unnamed: L1.1, U3.3 (LX1)
unnamed: R7.2, R20.2, U3.6 (MODE)
unnamed: Q1.4 (GATE2), R10.1
unnamed: R14.2, R23.1, U2.B3 (ZVC/TH2)
unnamed: EXT_TH_J.2, R13.2, U2.A1 (TH)
unnamed: C17.2, U2.A5 (REG)
unnamed: C12.1, U2.B1 (CP)
unnamed: C12.2, C13.1, R12.1, U2.C1 (BATT)
unnamed: C14.1, R18.2, U2.C4 (PCKP)
unnamed: C16.2, R5.2, R6.2, U3.8 (FB)
unnamed: R8.1, U3.5 (EN)
STATUS_LED: R24.1; also elsewhere on the board
VBAT: BAT_J.1, R4.1, R12.2, U2.A4 (CSN)
VBUS: C8.1 (+), C9.2, D2.1 (K), Q1.3 (SOURCE2), R8.2, R18.1, R20.1, R23.2, U3.4 (VIN), USB_C.A4 (VBUS), USB_C.A9 (VBUS), USB_C.B4 (VBUS), USB_C.B9 (VBUS)
VDD: C15.2, R11.2, R21.2, R22.2, U4.1 (OUT), U4.2 (ADJ/SENSE); also elsewhere on the board
VSSA: BAT_J.2, C8.2 (-), C9.1, C10.1, C11.1, C13.2, C14.2, C17.1, D2.2 (A), EXT_TH_J.1, R5.1, R7.1, R13.1, R14.1, R19.2, U2.A2 (GND), U3.7 (GND), U4.7 (EPAD), USB_C.A1 (GND), USB_C.A12 (GND), USB_C.B1 (GND), USB_C.B12 (GND), USB_C.S1 (SHIELD), USB_C.S2 (SHIELD), USB_C.S3 (SHIELD), USB_C.S4 (SHIELD); also elsewhere on the board

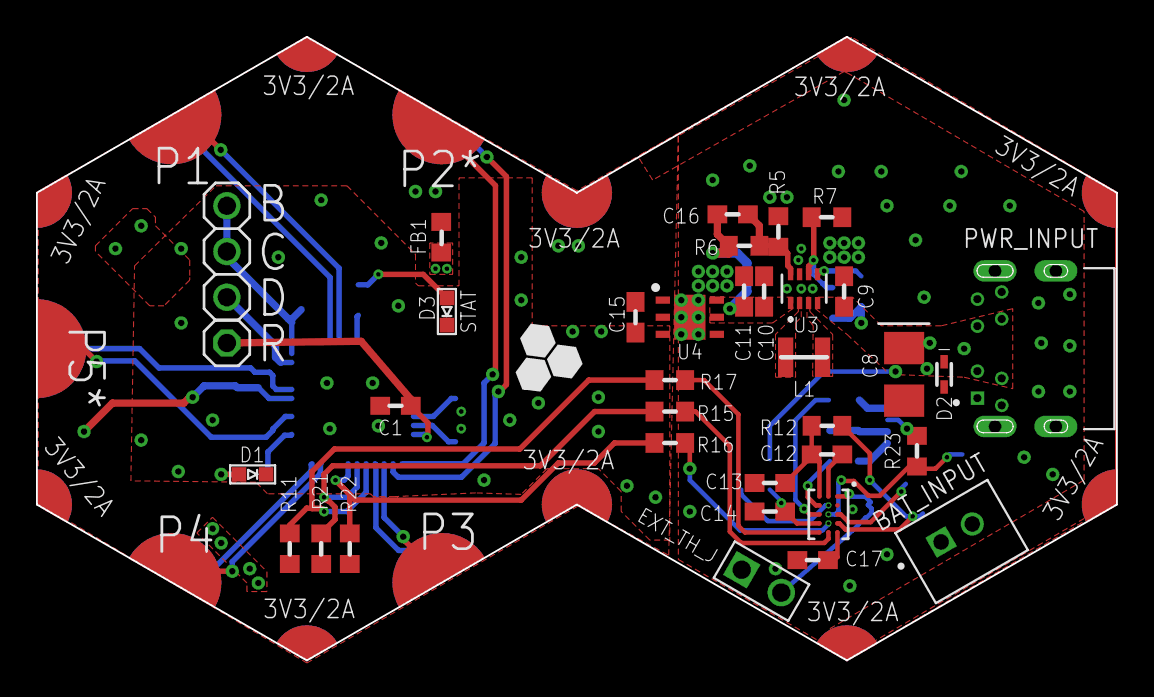
[picture p11: board H05R00.brd from above]

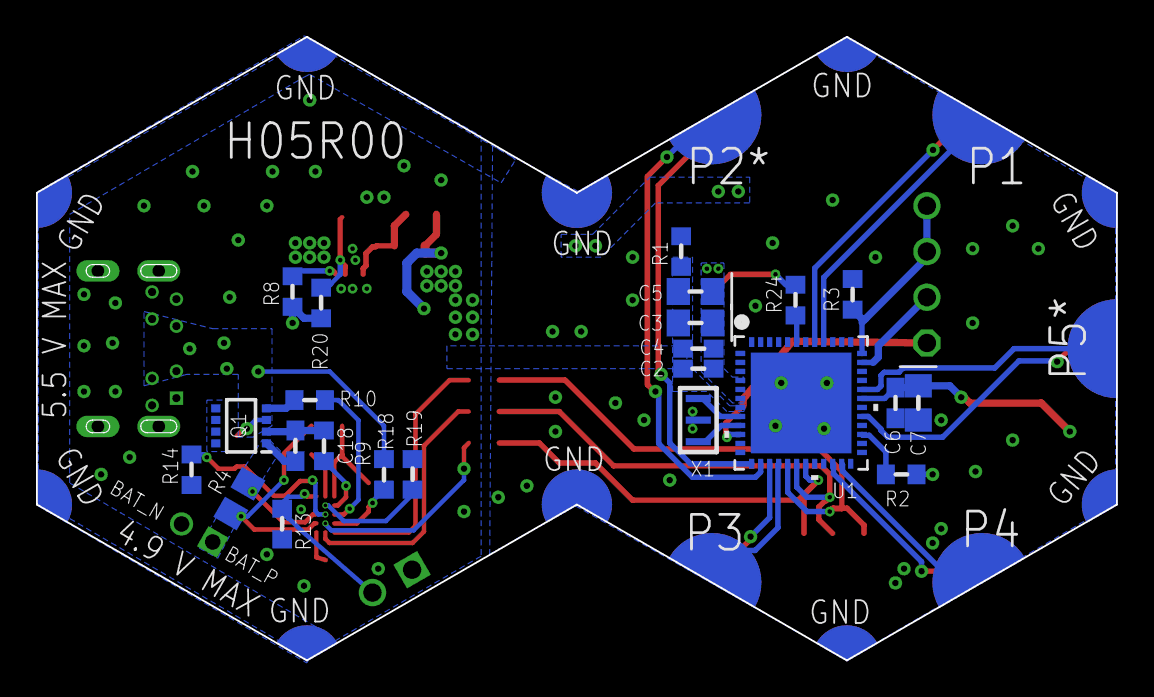
[picture p12: board H05R00.brd from below]

Board: 2 copper layers, 60.0 x 34.6 mm, 59 parts (23 on the bottom side), 50 nets.
