HexabitzPlatform/H05R0x/(commit log)

2023-10-06 -Creating the repo and adding the intail design files
    [H05R0.brd, H05R0.sch]
2023-10-14 -The final design filles (for this version)
    [H05R0.brd, H05R00.brd, H05R00.sch, H05R00.xlsx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]
2023-11-05 - Add power pads for the power hexagon and improve the silkscreen layer look
    [H05R00.brd, H05R00.sch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]
2023-11-05 -Fix BOM
    [H05R00.xlsx]
2024-01-01 Creat H05R00 folder that includes all files
    [H05R00.brd, H05R00.sch, H05R00.xlsx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]
2024-01-02 -Standarize the files and folders
    [H05R0.brd, H05R0.sch, H05R0.xlsx, H05R00.xlsx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]
2024-02-17 -Adding wire to board terminal block
    [H05R0.brd, H05R0.sch, H05R0.xlsx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]
2024-02-18 -Correcting the placement of the additional junction and including it in the Bill of Materials (BOM).
    [H05R0.brd, H05R0.sch, H05R0.xlsx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]
2024-04-17 -Update the logo and add TVS
    [H05R0.brd, H05R0.sch, H05R0.xlsx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]
2024-04-17 Fix issue in the layout
    [H05R0.brd]
2024-08-27 Unreviewed version - update the design by adding additional transistors in parallel.
    [H05R0.brd, H05R0.sch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]
2024-09-10 - New version: Schematic finished and reviewed. Other files have not been modified yet for the new design.
    [H05R0.brd, H05R0.sch]
2024-10-08 -New Version (1b), reviewed and finished - adding the charging detection & current measurement circuit
    [H05R0.brd, H05R0.sch, H05R0.xlsx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]
