HexabitzPlatform/H05R0x/(notices)

Notices in the files:
parts and their libraries:
HEXABITZ_ICs: COPYRIGHT: Copyright (C) 2022 Ultra Librarian. All rights reserved.
HEXABITZ_ICs: COPYRIGHT: Copyright (C) 2023 Ultra Librarian. All rights reserved.
COPYRIGHT: Copyright (C) 2021 Ultra Librarian. All rights reserved.
COPYRIGHT: Copyright (C) 2024 Ultra Librarian. All rights reserved.
